Tommie1236/desk-mh/kicad/screenshot.png

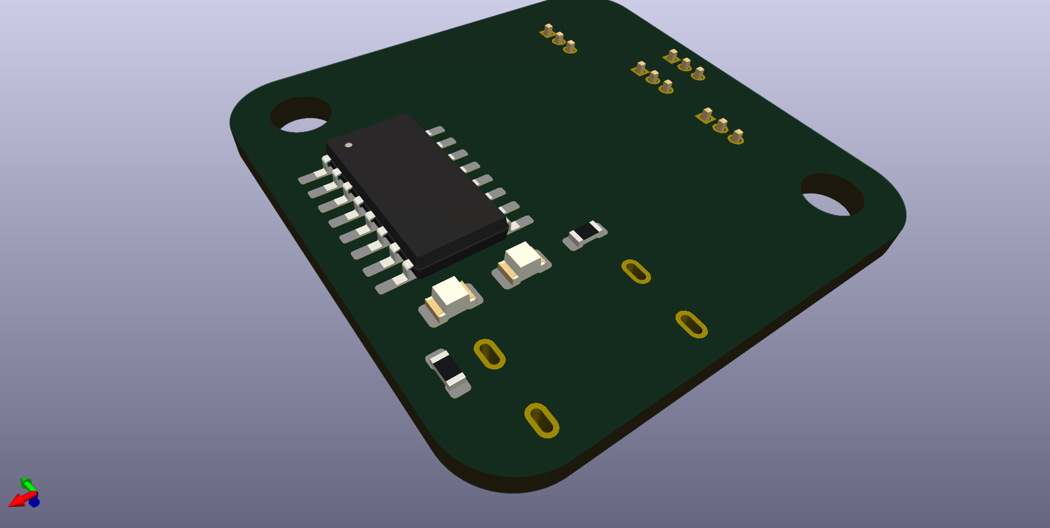
kicad/screenshot.png
