Tommie1236/desk-mh/JOURNAL.md

<!--
  ===================    !!READ THIS NOTICE!!   ====================
  DO NOT edit this file manually. Your changes WILL BE OVERWRITTEN!
  This journal is auto generated and updated by Hack Club Blueprint.
  To edit this file, please edit your journal entries on Blueprint.
  ==================================================================
-->

## 10/20/2025 - complete pcb design and start cad model.  

### Desk toy Movinghead stagelight

Hi, starting this project on blueprint, have been working on it for a little while in the background before i discoverd this.

As such i have already designed the schematic and pcb for my project and have already ordered and received it. 

### Why this project?
It started with me wanting to get into more complex pcb's. I had designed a couple of relatively simple tht pcb's for a [custom midi controller](https://www.github.com/tommie1236/simple-midi-controller) and a [dmx art-net node](https://www.github.com/tommie1236/pico-art-net-node). The process/journal for those 2 projects can be found on SoM.

And i love working in/with AV and mostly lighting equipment and the birthday of a buddy with whom i have a little AV services company was coming up. So i thought it would be a cool idea to make a tiny desk sized stage light toy for him that can be controlled via DMX512 like actual stage lights. 

### The process
So i took a attiny1616 mcu as base because that doesn't really need external components like flash or a crystal that could be messed up and because i wanted the pcb to be very tiny. its currently 30x30mm but could porbably get it to 20x20mm if i wanted. 
I will add a couple of images in the next journal as i don't have them easily available right now. But i will attach a render of the pcb right here.

(The real pcb is produced in a much more clean black but i can't figure out how to change kicad's preview colors)



I don't know a lot about the process of making the schematic and pcb anymore as that was at least a couple of weeks ago. (started while SoM was running but didn't enter it as i don't have a working kicad wakatime plugin so i couldn't log any hours working on it and SoM isn't really geard towareds hardware projects so i just worked on it in the background not logging anything)

**Just started with listing the requirements:**
- needs to be able to recieve actual DMX512 signals (basicly a glorified and differential uart)
- needs to control 2 small servo motors for pan and tilt.
- needs to be usb-c powered (and allow for usb-c to usb-c cables. don't need whole PD power)
- needs to control 1 (or 7, depending if i go with a moving head spot or wash, not sure yet) 10mm ws2812b leds. 
- needs to be able to have a easily settable dmx address via dip switches. 

And went searching for mcu's that didn't require many or complicated external components, were small in footprint and had enough pins. I arrived at the attiny-1 series from microchip that looked pretty good and chose the attiny1616. This would be a challenge on its own because i have pretty much only worked with rp2040 based boards before and almost no AVR mcu's. 
Probably spend around 20-30 hours researching and creating the schematic/pcb but don't know exactly as wakatime isn't working in kicad.

I don't realy know a lot more details about the pcb design part.

### Current state

As said before i already have a bunch of pcb's in hand (20, jlc didn't like the tiny board size so i put them in panels of 4 boards each. Photo's in next journal entry.)
I also started working on the cad model but that isn't very far yet and will also be documented in the next entry as this one is already just above 3K chars. I'm realy not comfortable with cad and still need to learn freecad a lot more. so this is also a good way to do that.  

## 10/25/2025 - Started assembling pcb and first tests.  

Today i started assembling the pcb with the parts i already have. i'm still missing a couple of resistors and capacitors that i forgot to take from the parts bin at my school. 

This was my first real time soldering smd and using solderpaste/hot air. it isn't professional looking but i think it is pretty okay for a first time. 

Even though the usb-c pd spec calls for a 5k1 resistor from cc1 and 2 to gnd to request the default 5v 500mA and i was using a 5k6 because that was the closest available it still worked first time. 

After messing around a bit with making a updi programmer from a usb-uart adapter succesfully flashed the attiny with a blink program.
In theory this was very basic/simple. turn on, wait 500ms, turn off, wait 500ms again. but it was blinking very slow. instead of 500ms it took like 3 seconds for it to change. 
That is when i discoverd that the attiny 1 series can run at up to 20Mhz instead of just 20Mhz. By default it has a /6 clockdiv enabled so the mcu accually ran at 3.33Mhz instead of 20Mhz. that also explains the 3s delay. (500ms * 6 = 3000ms).

I have been trying to set the clockdivider to 0 for a bit now but every time it softbricks itself and i need to completly erase the mcu to reset the fuses and the clkdiv. I haven't figured out a solution yet.

The soldering of 2 boards, creating a programmer, writing a simple test program and then trying to debug the clk took about 3-5 hours. 

but at least the blink example and usb-c power works. 
(i have set the delay to 200ms instead of 500ms to get about 500ms real time here)

I can't figure out how to embed a video so here is the demo url
https://photos.app.goo.gl/bVNjHx33AUzLW4m67
