Tommie1236/desk-mh/freecad/model.FCStd

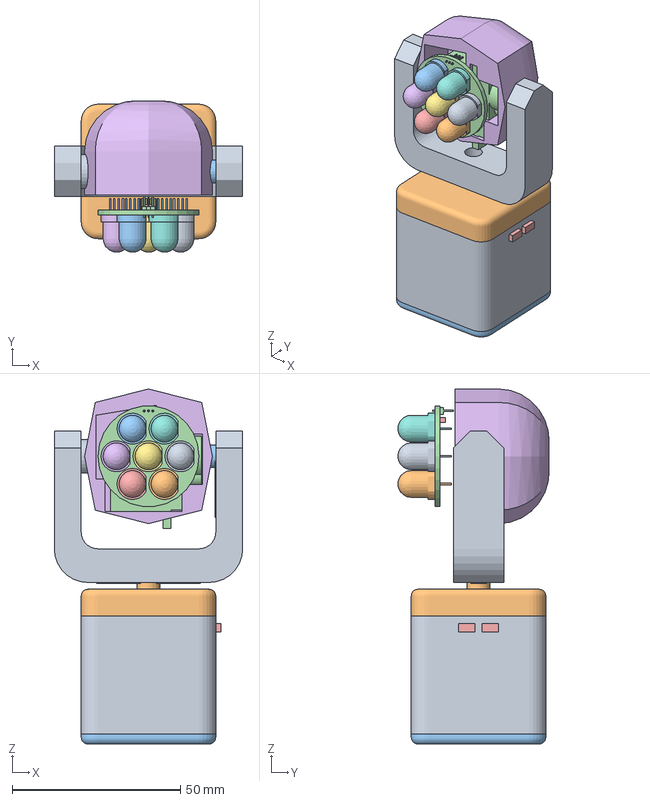
[picture p2: CAD file, 2026-10-16]
freecad/model.FCStd
56.0 x 45.0 x 105.5 mm
yoke
servo_pan_horn
servo_tilt_horn
Pcb_6f2
D6_Body_73fe772afc0b
D3_Body_6745e76b680d
D4_Body_3cb8fe2f0ec7
D2_Body_1b26e20a7068
D5_Body_d2217119cfab
D7_Body_c90e8d0ce7d0
D1_Body_3633d8c9922a
J1_PinHeader_1x03_P127mm_Vertical_e1a1fa364b88
C1_C_1206_3216Metric_496a3fa6a6e9
head
Pcb_8e001
R2_R_0603_1608Metric_c0dbaa8287a9
C1_C_0805_2012Metric_ab9d0faecc92
R5_R_0603_1608Metric_675953070315
C2_C_0603_1608Metric_dd00bf1265fb
J5_PinHeader_1x03_P127mm_Vertical_e15d524fadd9
J3_PinHeader_1x03_P127mm_Vertical_6b7c94121bf5
C4_C_0805_2012Metric_bbf296a020a4
J4_PinHeader_1x03_P127mm_Vertical_e032fff0e01a
C3_C_0603_1608Metric_5d5fa9ee6bbb
R1_R_0603_1608Metric_9f161c2c565b
U2_SOIC-8_3.9x4.9mm_P1.27mm_666dbd7d03b0
J2_PinHeader_1x03_P127mm_Vertical_57ae01bca7ac
D1_LED_0805_2012Metric_083ece47bab1
SW1_SOIC-16W_5.3x10.2mm_P1.27mm_f9d376eae046
D2_LED_0805_2012Metric_d5bf42b78a44
R3_R_0603_1608Metric_19e928c7c45b
R4_R_0603_1608Metric_1e1e9a3f7256
base
base cover
bottom cover
servo_tilt
servo_pan
