Tommie1236/desk-mh/led_8mm_4pin.step

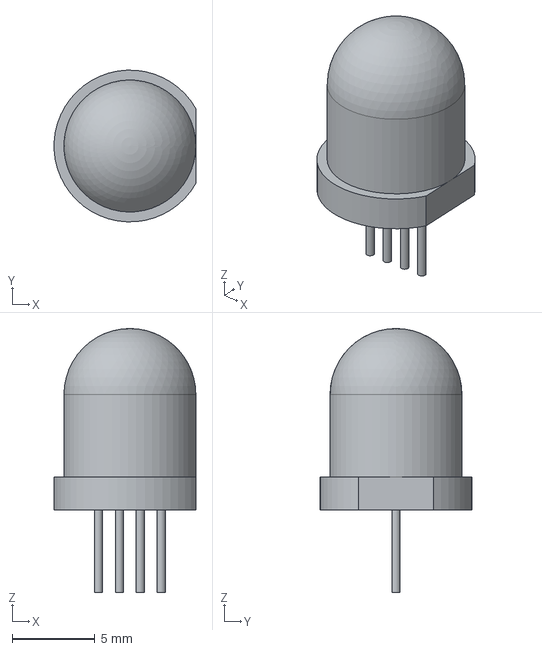
[picture p3: CAD file, 2026-10-14]
led_8mm_4pin.step
8.59 x 9.19 x 16.0 mm
