Tommie1236/desk-mh/kicad/led_pcb.kicad_pcb

## KiCad design kicad/led_pcb.kicad_pcb (2026-10-14)

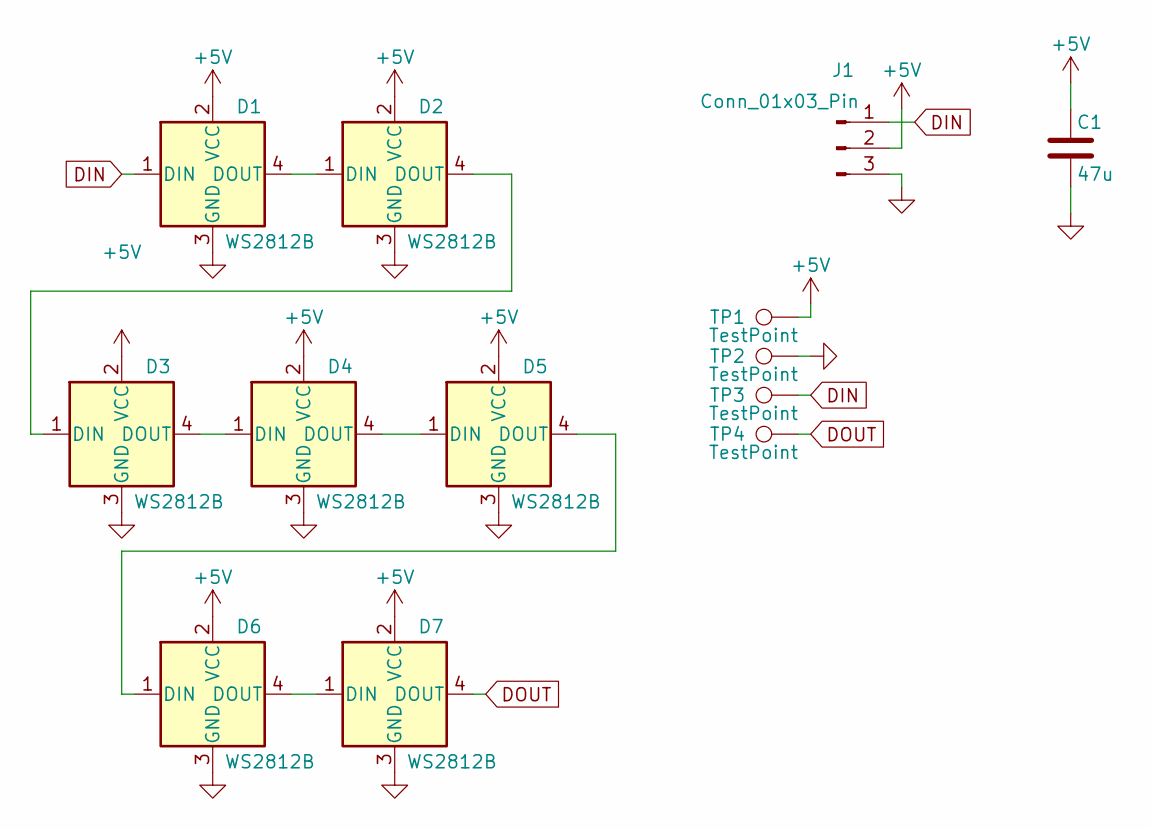
[picture p4: schematic led_pcb.kicad_sch]

Parts:
C1: 47u; C_1206_3216Metric
D1, D2, D3, D4, D5, D6, D7: WS2812B; 8mm 4pin
J1: Conn_01x03_Pin; PinHeader_1x03_P1.27mm_Vertical
TP1, TP2, TP3, TP4: TestPoint; TestPoint_Pad_D1.0mm

Connections:
+5V: C1.1, D1.2 (VCC), D2.2 (VCC), D3.2 (VCC), D4.2 (VCC), D5.2 (VCC), D6.2 (VCC), D7.2 (VCC), J1.2, TP1.1
DIN: D1.1 (DIN), J1.1, TP3.1
DOUT: D7.4 (DOUT), TP4.1
GND: C1.2, D1.3 (GND), D2.3 (GND), D3.3 (GND), D4.3 (GND), D5.3 (GND), D6.3 (GND), D7.3 (GND), J1.3, TP2.1
unnamed: D1.4 (DOUT), D2.1 (DIN)
unnamed: D2.4 (DOUT), D3.1 (DIN)
unnamed: D3.4 (DOUT), D4.1 (DIN)
unnamed: D4.4 (DOUT), D5.1 (DIN)
unnamed: D5.4 (DOUT), D6.1 (DIN)
unnamed: D6.4 (DOUT), D7.1 (DIN)

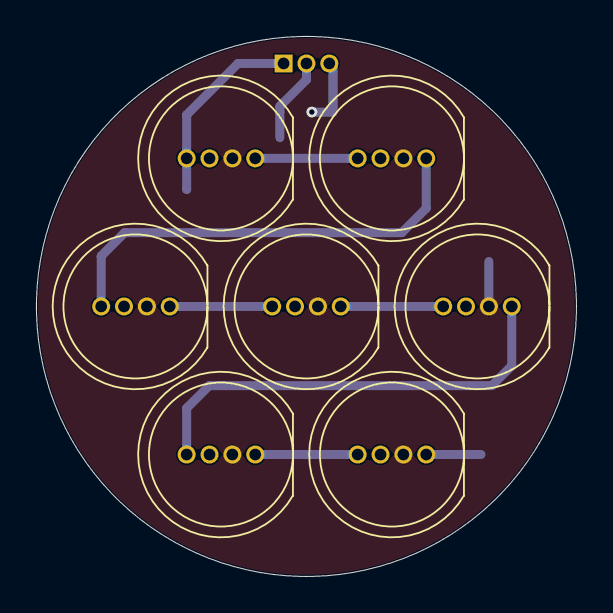
[picture p5: board led_pcb.kicad_pcb from above]

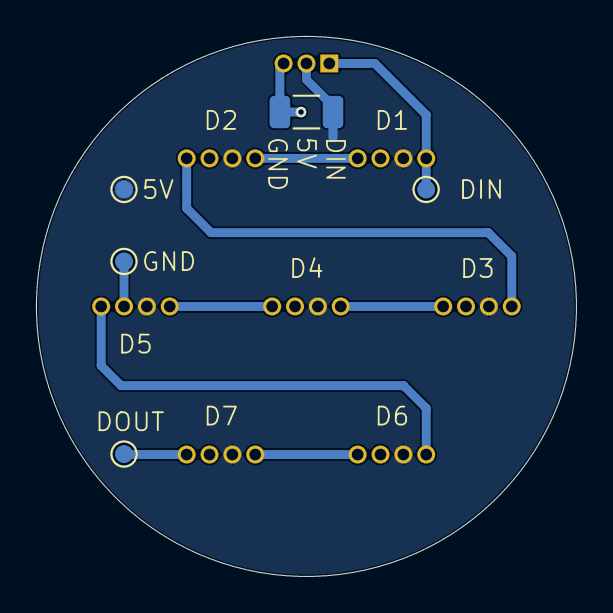
[picture p6: board led_pcb.kicad_pcb from below]

Board: 2 copper layers, 30.0 x 30.0 mm, 13 parts (6 on the bottom side), 10 nets.
