Tommie1236/desk-mh/kicad/desk-mh.kicad_pcb

## KiCad design kicad/desk-mh.kicad_pcb (2025-10-16)

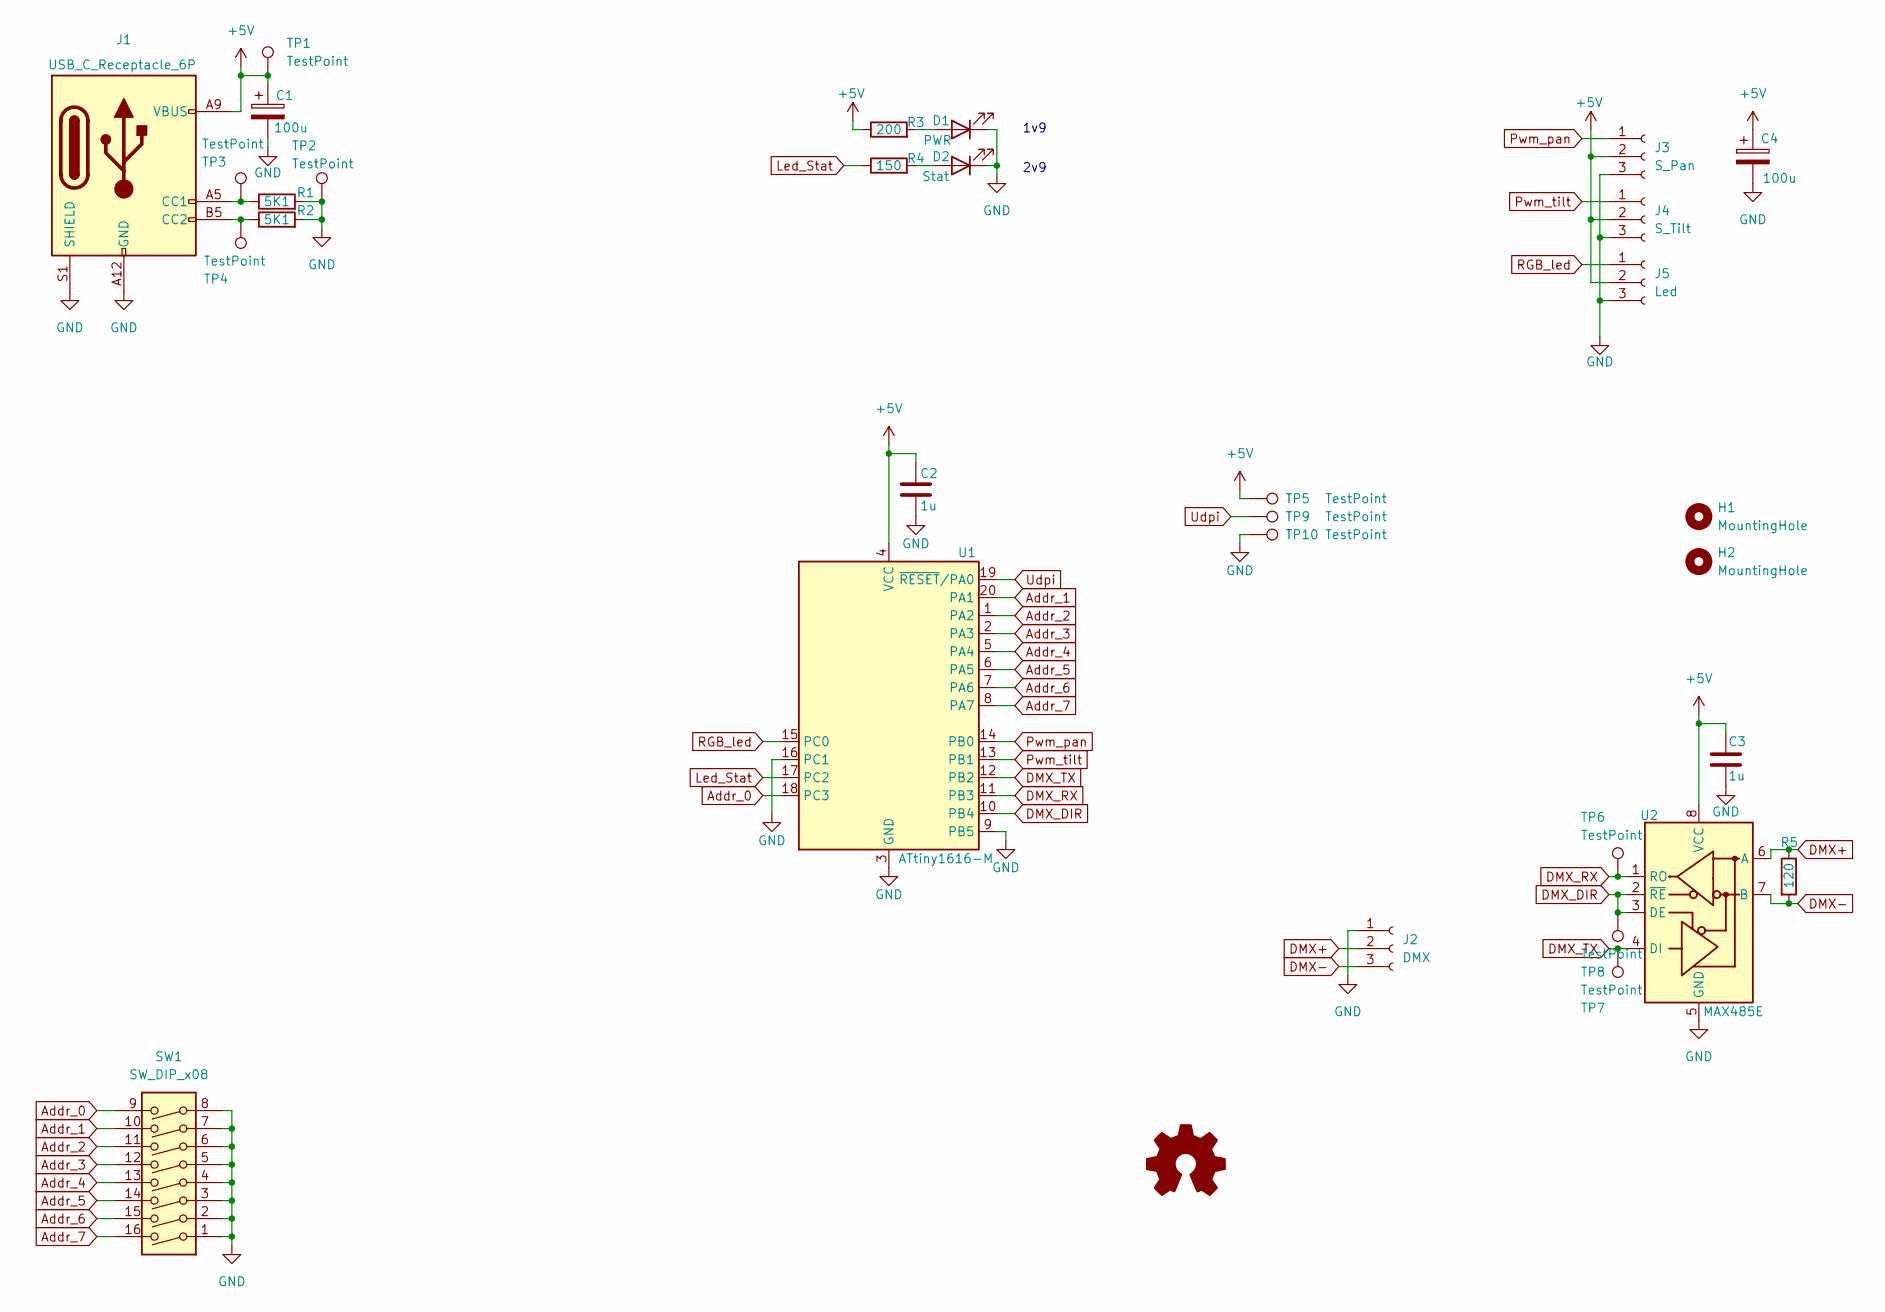
[picture p7: schematic desk-mh.kicad_sch]

Parts:
C1, C4: 100u; C_0805_2012Metric
C2, C3: 1u; C_0603_1608Metric
D1: PWR; LED_0805_2012Metric
D2: Stat; LED_0805_2012Metric
H1, H2: MountingHole; MountingHole_3.5mm
J1: USB_C_Receptacle_6P; USB_C_Receptacle_HRO_TYPE-C-31-M-17
J2: DMX; PinHeader_1x03_P1.27mm_Vertical
J3: S_Pan; PinHeader_1x03_P1.27mm_Vertical
J4: S_Tilt; PinHeader_1x03_P1.27mm_Vertical
J5: Led; PinHeader_1x03_P1.27mm_Vertical
R1, R2: 5K1; R_0603_1608Metric
R3: 200; R_0603_1608Metric
R4: 150; R_0603_1608Metric
R5: 120; R_0603_1608Metric
SW1: SW_DIP_x08; SOIC-16W_5.3x10.2mm_P1.27mm
SYM1: Logo_Open_Hardware_Small; OSHW-Logo2_7.3x6mm_SilkScreen
TP1, TP2, TP3, TP4, TP6, TP7, TP8: TestPoint; TestPoint_Pad_D1.0mm
TP5, TP9, TP10: TestPoint; TestPoint_Pad_D1.5mm
U1: ATtiny1616-M; VQFN-20-1EP_3x3mm_P0.4mm_EP1.7x1.7mm
U2: MAX485E; SOIC-8_3.9x4.9mm_P1.27mm

Connections:
+5V: C1.1, C2.1, C3.1, C4.1, J1.A9 (VBUS), J1.B9 (VBUS), J3.2, J4.2, J5.2, R3.1, TP1.1, TP5.1, U1.4 (VCC), U2.8 (VCC)
Addr_0: SW1.9, U1.18 (PC3)
Addr_1: SW1.10, U1.20 (PA1)
Addr_2: SW1.11, U1.1 (PA2)
Addr_3: SW1.12, U1.2 (PA3)
Addr_4: SW1.13, U1.5 (PA4)
Addr_5: SW1.14, U1.6 (PA5)
Addr_6: SW1.15, U1.7 (PA6)
Addr_7: SW1.16, U1.8 (PA7)
DMX+: J2.2, R5.1, U2.6 (A)
DMX-: J2.3, R5.2, U2.7 (B)
DMX_DIR: TP8.1, U1.10 (PB4), U2.2 (~RE), U2.3 (DE)
DMX_RX: TP6.1, U1.11 (PB3), U2.1 (RO)
DMX_TX: TP7.1, U1.12 (PB2), U2.4 (DI)
GND: C1.2, C2.2, C3.2, C4.2, D1.1 (K), D2.1 (K), J1.A12 (GND), J1.B12 (GND), J1.S1 (SHIELD), J2.1, J3.3, J4.3, J5.3, R1.2, R2.2, SW1.1, SW1.2, SW1.3, SW1.4, SW1.5, SW1.6, SW1.7, SW1.8, TP2.1, TP10.1, U1.3 (GND), U1.9 (PB5), U1.16 (PC1), U1.21 (GND), U2.5 (GND)
Led_Stat: R4.1, U1.17 (PC2)
unnamed: D1.2 (A), R3.2
unnamed: D2.2 (A), R4.2
unnamed: J1.A5 (CC1), R1.1, TP3.1
unnamed: J1.B5 (CC2), R2.1, TP4.1
Pwm_pan: J3.1, U1.14 (PB0)
Pwm_tilt: J4.1, U1.13 (PB1)
RGB_led: J5.1, U1.15 (PC0)
Udpi: TP9.1, U1.19 (~RESET/PA0)

Notes on the sheet:
2v9
1v9

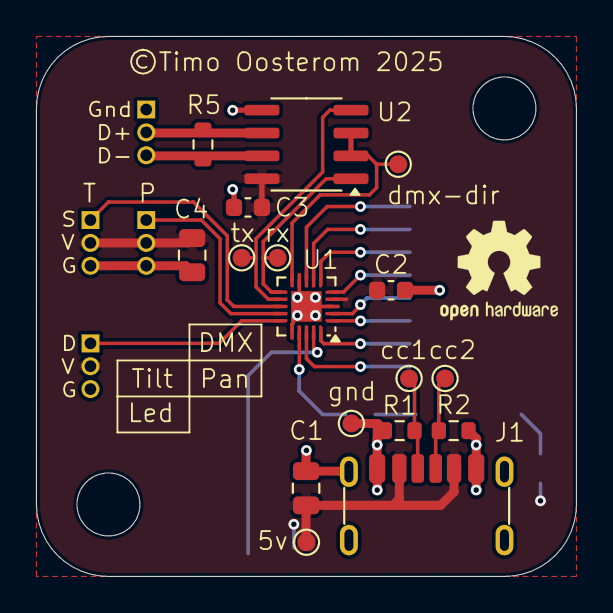
[picture p8: board desk-mh.kicad_pcb from above]

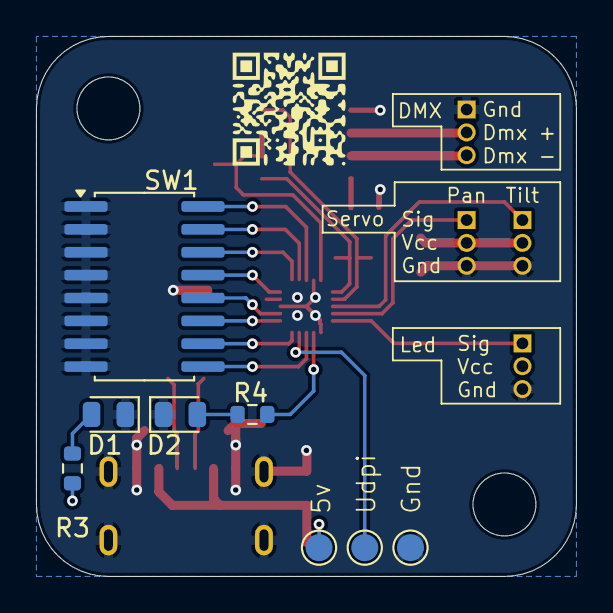
[picture p9: board desk-mh.kicad_pcb from below]

Board: 2 copper layers, 30.0 x 30.0 mm, 32 parts (8 on the bottom side), 24 nets.
