Tommie1236/desk-mh/(commit log)

2025-10-16 started 3d model
    [model.FCStd]
2025-10-17 finished bottom cover and pcb part of base
    [model.FCStd]
2025-10-17 added servo and pcb models
    [model.FCStd]
2025-10-25 updated makefile to program via a usb-uart instead of jtag2updi.
2025-10-25 created test program (the hardware works) but am still stuck on 3.33Mhz instead of 20Mhz. sadly
    [main.c, main.h]
2026-04-29 added led pcb to repo and cleaned up kicad folder
    [led_pcb.kicad_pcb, led_pcb.kicad_sch]
2026-04-30 don't know what changed, little ago and git doesn't support binary diffs
    [model.FCStd]
2026-10-14 added led models to pcb
