Tommie1236/desk-mh/(notices)

Notices in the files:
kicad/desk-mh.kicad_pcb:
©Timo Oosterom 2025
